lazulyTech/URC_IO-Expander/README.md

# UEC Robotics Competition

## [ゲームルール](GameRule/main.pdf)

日本語がレンダリングされないため，ダウンロードしてご利用ください．
