lazulyTech/URC_IO-Expander/Board/ExternalLib/ADUM140D0BRZ/ADUM140D0BRZ.step

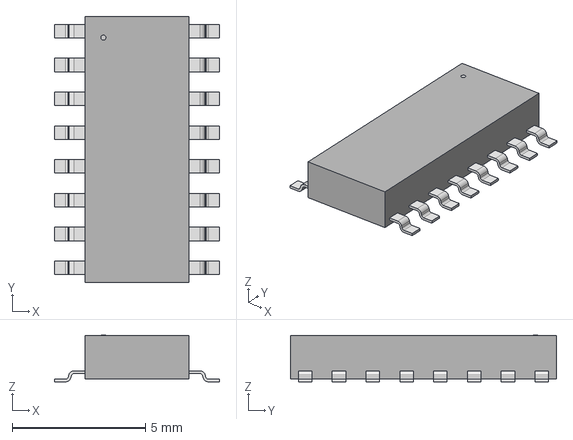
[picture p15: CAD file, 2022-06-05]
Board/ExternalLib/ADUM140D0BRZ/ADUM140D0BRZ.step
6.20 x 10.0 x 1.75 mm
