lazulyTech/URC_IO-Expander/Board/ExternalLib/TB6612FNG/TB6612FNG.step

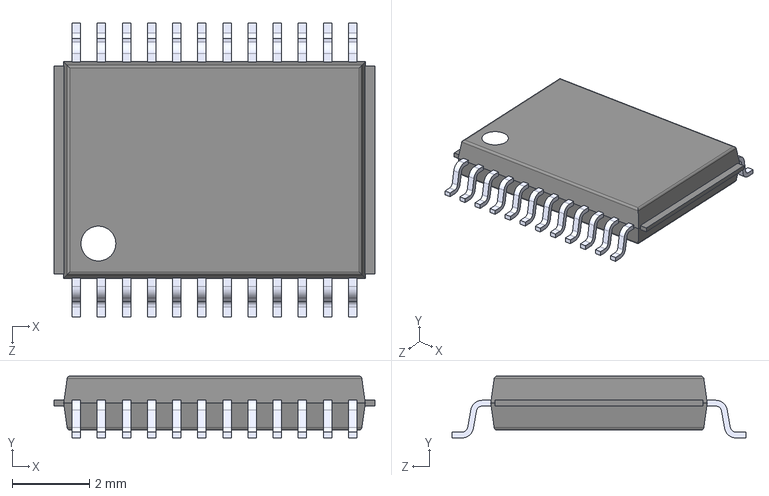
[picture p16: CAD file, 2022-06-05]
Board/ExternalLib/TB6612FNG/TB6612FNG.step
8.30 x 1.60 x 7.60 mm
