lazulyTech/URC_IO-Expander/Board/ExternalLib/TB67H450FNG/TB67H450FNG.step

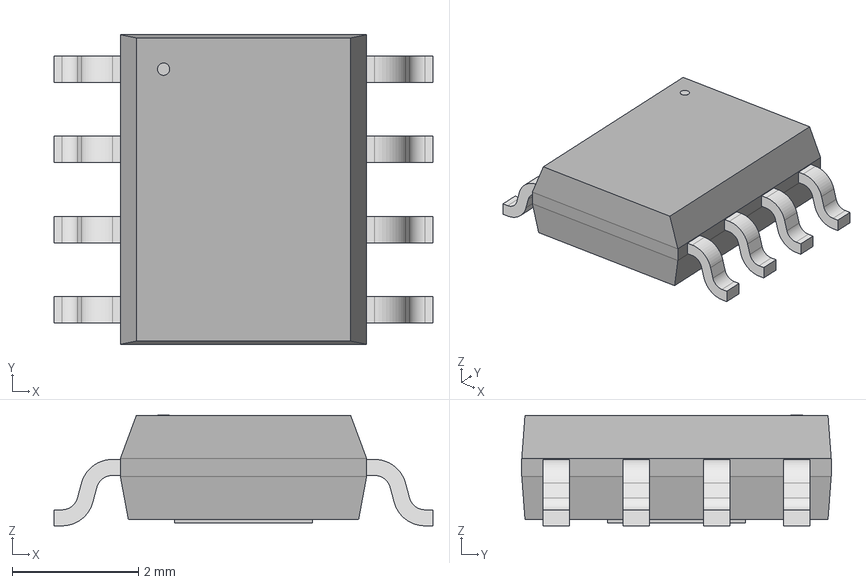
[picture p17: CAD file, 2022-06-05]
Board/ExternalLib/TB67H450FNG/TB67H450FNG.step
6.00 x 4.90 x 1.75 mm
