lazulyTech/URC_IO-Expander/Board/URC_ver2/URC_ver2.kicad_pcb

## KiCad design Board/URC_ver2/URC_ver2.kicad_pcb (2022-07-22)

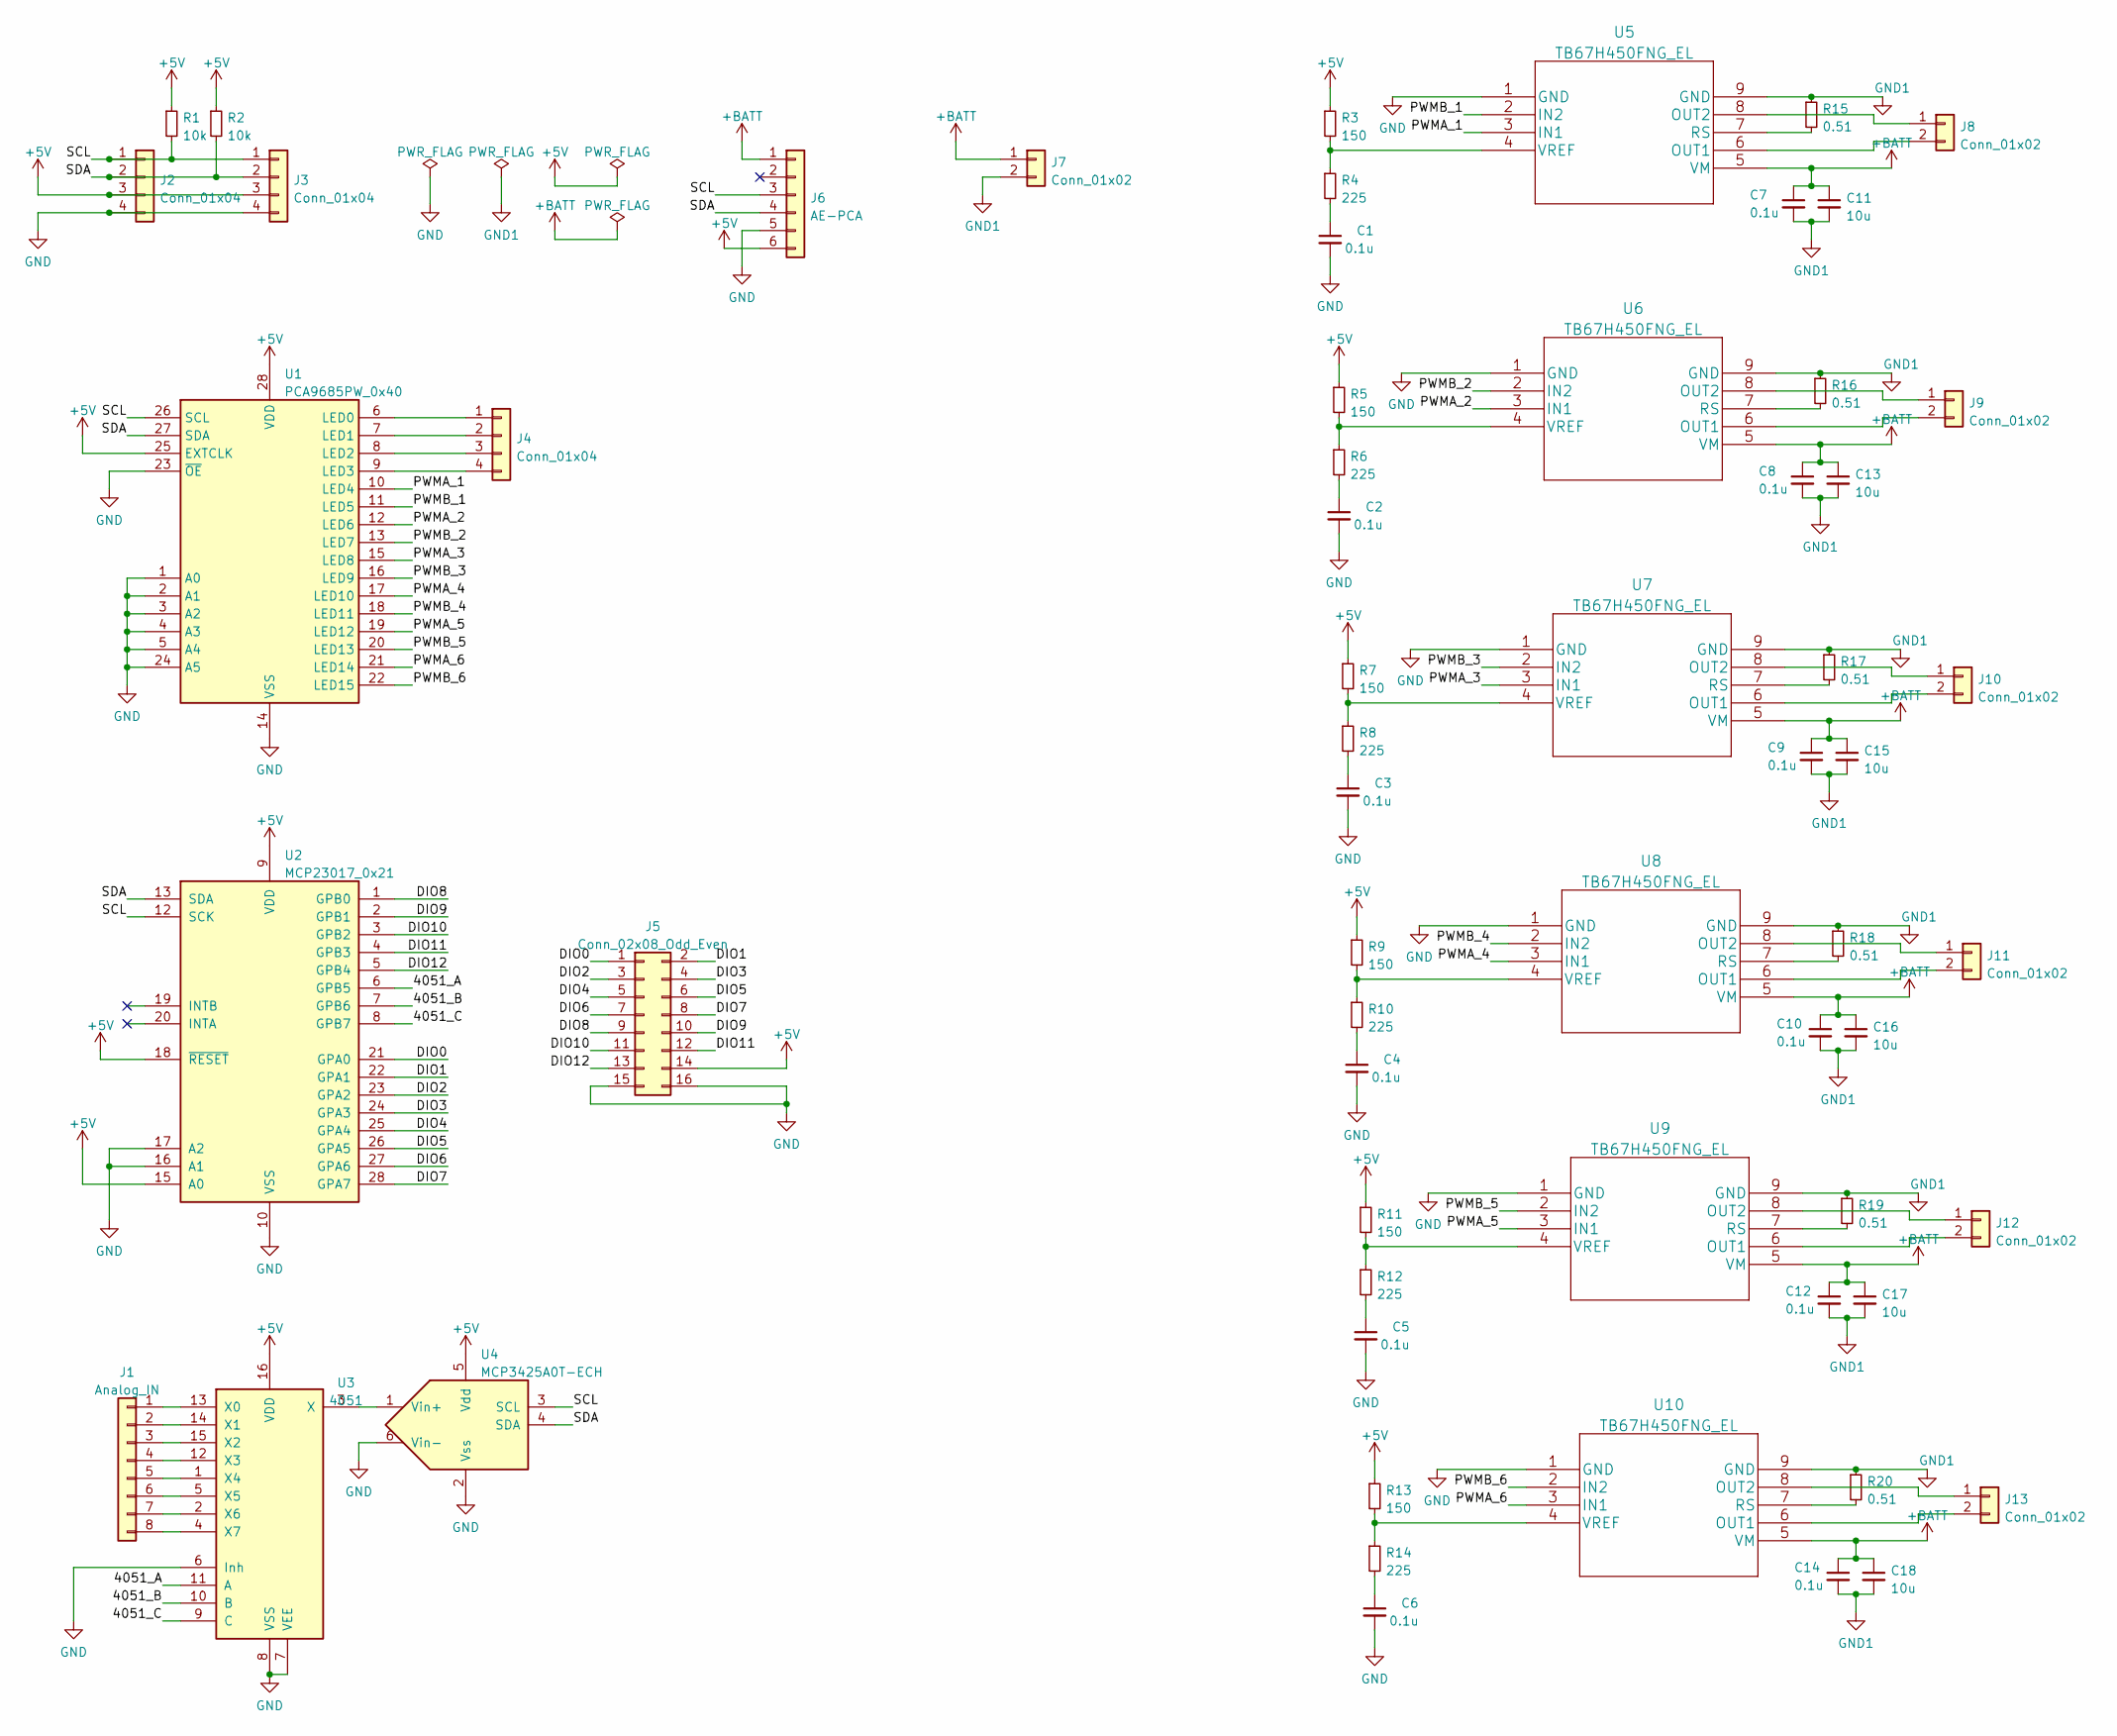
[picture p18: schematic URC_ver2.kicad_sch, BCRC Dev-Board]

Parts:
C1, C2, C3, C4, C5, C6, C7, C8, C9, C10, C12, C14: 0.1u; C_0603_1608Metric_Pad1.08x0.95mm_HandSolder
C11, C13, C15, C16, C17, C18: 10u; C_0603_1608Metric_Pad1.08x0.95mm_HandSolder
J1: Analog_IN; PinSocket_1x08_P2.54mm_Vertical
J2: Conn_01x04; NS-Tech_Grove_1x04_P2mm_Vertical
J3, J4: Conn_01x04; PinSocket_1x04_P2.54mm_Vertical
J5: Conn_02x08_Odd_Even; PinSocket_2x08_P2.54mm_Vertical
J6: AE-PCA; PinSocket_1x06_P2.54mm_Vertical
J7, J8, J9, J10, J11, J12, J13: Conn_01x02; JST_XH_B2B-XH-A_1x02_P2.50mm_Vertical
R1, R2: 10k; R_0603_1608Metric_Pad0.98x0.95mm_HandSolder
R3, R5, R7, R9, R11, R13: 150; R_0603_1608Metric_Pad0.98x0.95mm_HandSolder
R4, R6, R8, R10, R12, R14: 225; R_0603_1608Metric_Pad0.98x0.95mm_HandSolder
R15, R16, R17, R18, R19, R20: 0.51; R_Axial_DIN0204_L3.6mm_D1.6mm_P5.08mm_Horizontal
U1: PCA9685PW_0x40; TSSOP-28_4.4x9.7mm_P0.65mm
U2: MCP23017_0x21; DIP-28_W7.62mm
U3: 4051; DIP-16_W7.62mm_LongPads
U4: MCP3425A0T-ECH; SOT-23-6_Handsoldering
U5, U6, U7, U8, U9, U10: TB67H450FNG_EL; TB67H450FNG

Connections:
+5V: J2.3, J3.3, J5.14, J6.6, R1.1, R2.1, R3.1, R5.1, R7.1, R9.1, R11.1, R13.1, U1.25 (EXTCLK), U1.28 (VDD), U2.9 (VDD), U2.15 (A0), U2.18 (~RESET), U3.16 (VDD), U4.5 (Vdd)
+BATT: C7.1, C8.1, C9.1, C10.1, C11.1, C12.1, C13.1, C14.1, C15.1, C16.1, C17.1, C18.1, J6.1, J7.1, U5.5 (VM), U6.5 (VM), U7.5 (VM), U8.5 (VM), U9.5 (VM), U10.5 (VM)
/4051_A: U2.6 (GPB5), U3.11 (A)
/4051_B: U2.7 (GPB6), U3.10 (B)
/4051_C: U2.8 (GPB7), U3.9 (C)
/DIO0: J5.1, U2.21 (GPA0)
/DIO1: J5.2, U2.22 (GPA1)
/DIO2: J5.3, U2.23 (GPA2)
/DIO3: J5.4, U2.24 (GPA3)
/DIO4: J5.5, U2.25 (GPA4)
/DIO5: J5.6, U2.26 (GPA5)
/DIO6: J5.7, U2.27 (GPA6)
/DIO7: J5.8, U2.28 (GPA7)
/DIO8: J5.9, U2.1 (GPB0)
/DIO9: J5.10, U2.2 (GPB1)
/DIO10: J5.11, U2.3 (GPB2)
/DIO11: J5.12, U2.4 (GPB3)
/DIO12: J5.13, U2.5 (GPB4)
/PWMA_1: U1.10 (LED4), U5.3 (IN1)
/PWMA_2: U1.12 (LED6), U6.3 (IN1)
/PWMA_3: U1.15 (LED8), U7.3 (IN1)
/PWMA_4: U1.17 (LED10), U8.3 (IN1)
/PWMA_5: U1.19 (LED12), U9.3 (IN1)
/PWMA_6: U1.21 (LED14), U10.3 (IN1)
/PWMB_1: U1.11 (LED5), U5.2 (IN2)
/PWMB_2: U1.13 (LED7), U6.2 (IN2)
/PWMB_3: U1.16 (LED9), U7.2 (IN2)
/PWMB_4: U1.18 (LED11), U8.2 (IN2)
/PWMB_5: U1.20 (LED13), U9.2 (IN2)
/PWMB_6: U1.22 (LED15), U10.2 (IN2)
/SCL: J2.1, J3.1, J6.3, R1.2, U1.26 (SCL), U2.12 (SCK), U4.3 (SCL)
/SDA: J2.2, J3.2, J6.4, R2.2, U1.27 (SDA), U2.13 (SDA), U4.4 (SDA)
GND: C1.2, C2.2, C3.2, C4.2, C5.2, C6.2, J2.4, J3.4, J5.15, J5.16, J6.5, U1.1 (A0), U1.2 (A1), U1.3 (A2), U1.4 (A3), U1.5 (A4), U1.14 (VSS), U1.23 (~OE), U1.24 (A5), U2.10 (VSS), U2.16 (A1), U2.17 (A2), U3.6 (Inh), U3.7 (VEE), U3.8 (VSS), U4.2 (Vss), U4.6 (Vin-), U5.1 (GND), U6.1 (GND), U7.1 (GND), U8.1 (GND), U9.1 (GND), U10.1 (GND)
GND1: C7.2, C8.2, C9.2, C10.2, C11.2, C12.2, C13.2, C14.2, C15.2, C16.2, C17.2, C18.2, J7.2, R15.1, R16.1, R17.1, R18.1, R19.1, R20.1, U5.9 (GND), U6.9 (GND), U7.9 (GND), U8.9 (GND), U9.9 (GND), U10.9 (GND)
unnamed: C1.1, R4.2
unnamed: C2.1, R6.2
unnamed: C3.1, R8.2
unnamed: C4.1, R10.2
unnamed: C5.1, R12.2
unnamed: C6.1, R14.2
unnamed: J1.1, U3.13 (X0)
unnamed: J1.2, U3.14 (X1)
unnamed: J1.3, U3.15 (X2)
unnamed: J1.4, U3.12 (X3)
unnamed: J1.5, U3.1 (X4)
unnamed: J1.6, U3.5 (X5)
unnamed: J1.7, U3.2 (X6)
unnamed: J1.8, U3.4 (X7)
unnamed: J8.1, U5.8 (OUT2)
unnamed: J8.2, U5.6 (OUT1)
unnamed: J9.1, U6.8 (OUT2)
unnamed: J9.2, U6.6 (OUT1)
unnamed: J10.1, U7.8 (OUT2)
unnamed: J10.2, U7.6 (OUT1)
unnamed: J11.1, U8.8 (OUT2)
unnamed: J11.2, U8.6 (OUT1)
unnamed: J12.1, U9.8 (OUT2)
unnamed: J12.2, U9.6 (OUT1)
unnamed: J13.1, U10.8 (OUT2)
unnamed: J13.2, U10.6 (OUT1)
unnamed: R3.2, R4.1, U5.4 (VREF)
unnamed: R5.2, R6.1, U6.4 (VREF)
unnamed: R7.2, R8.1, U7.4 (VREF)
unnamed: R9.2, R10.1, U8.4 (VREF)
unnamed: R11.2, R12.1, U9.4 (VREF)
unnamed: R13.2, R14.1, U10.4 (VREF)
unnamed: R15.2, U5.7 (RS)
unnamed: R16.2, U6.7 (RS)
unnamed: R17.2, U7.7 (RS)
unnamed: R18.2, U8.7 (RS)
unnamed: R19.2, U9.7 (RS)
unnamed: R20.2, U10.7 (RS)
unnamed: J4.1, U1.6 (LED0)
unnamed: J4.2, U1.7 (LED1)
unnamed: J4.3, U1.8 (LED2)
unnamed: J4.4, U1.9 (LED3)
unnamed: U3.3 (X), U4.1 (Vin+)

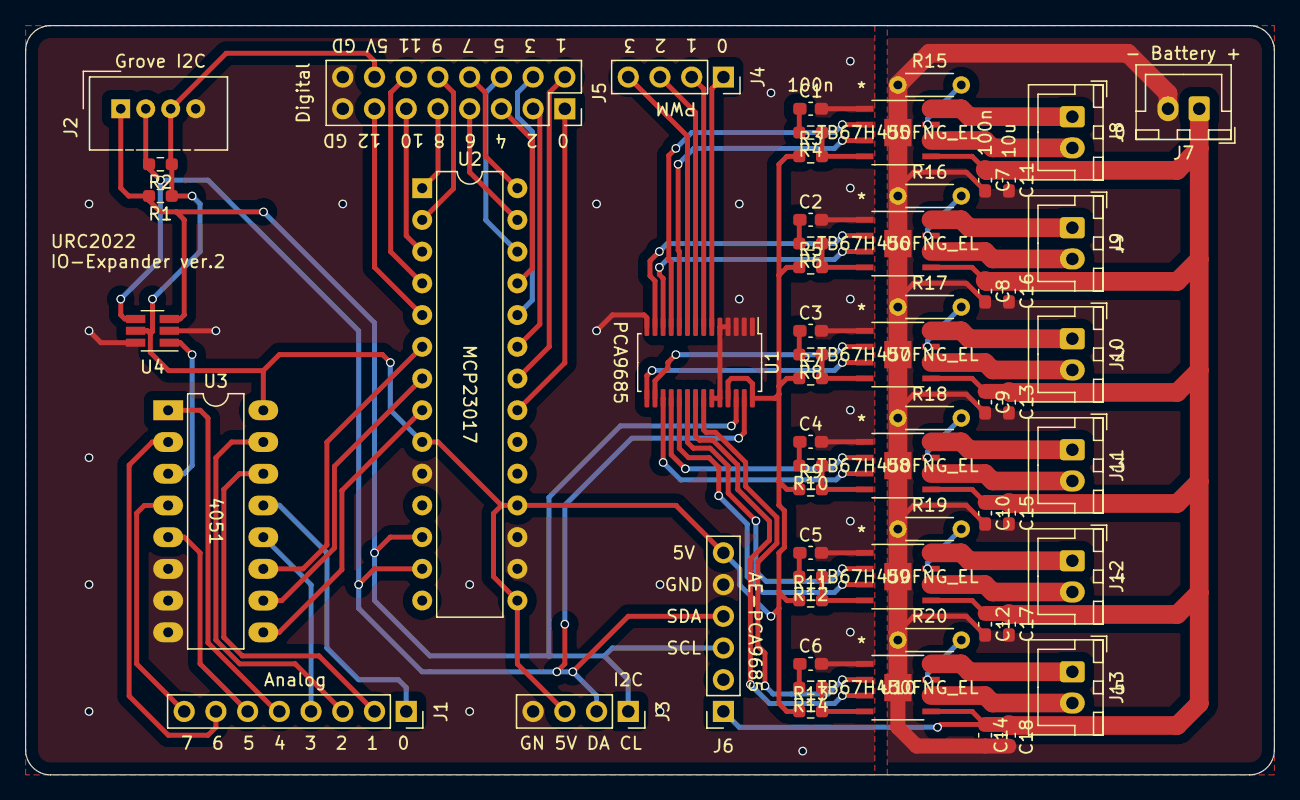
[picture p19: board URC_ver2.kicad_pcb from above]

Board: 2 copper layers, 100.0 x 60.0 mm, 61 parts (0 on the bottom side), 77 nets.
