lazulyTech/URC_IO-Expander/Board/URC_I2C/URC_I2C.kicad_pcb

## KiCad design Board/URC_I2C/URC_I2C.kicad_pcb (2022-06-05)

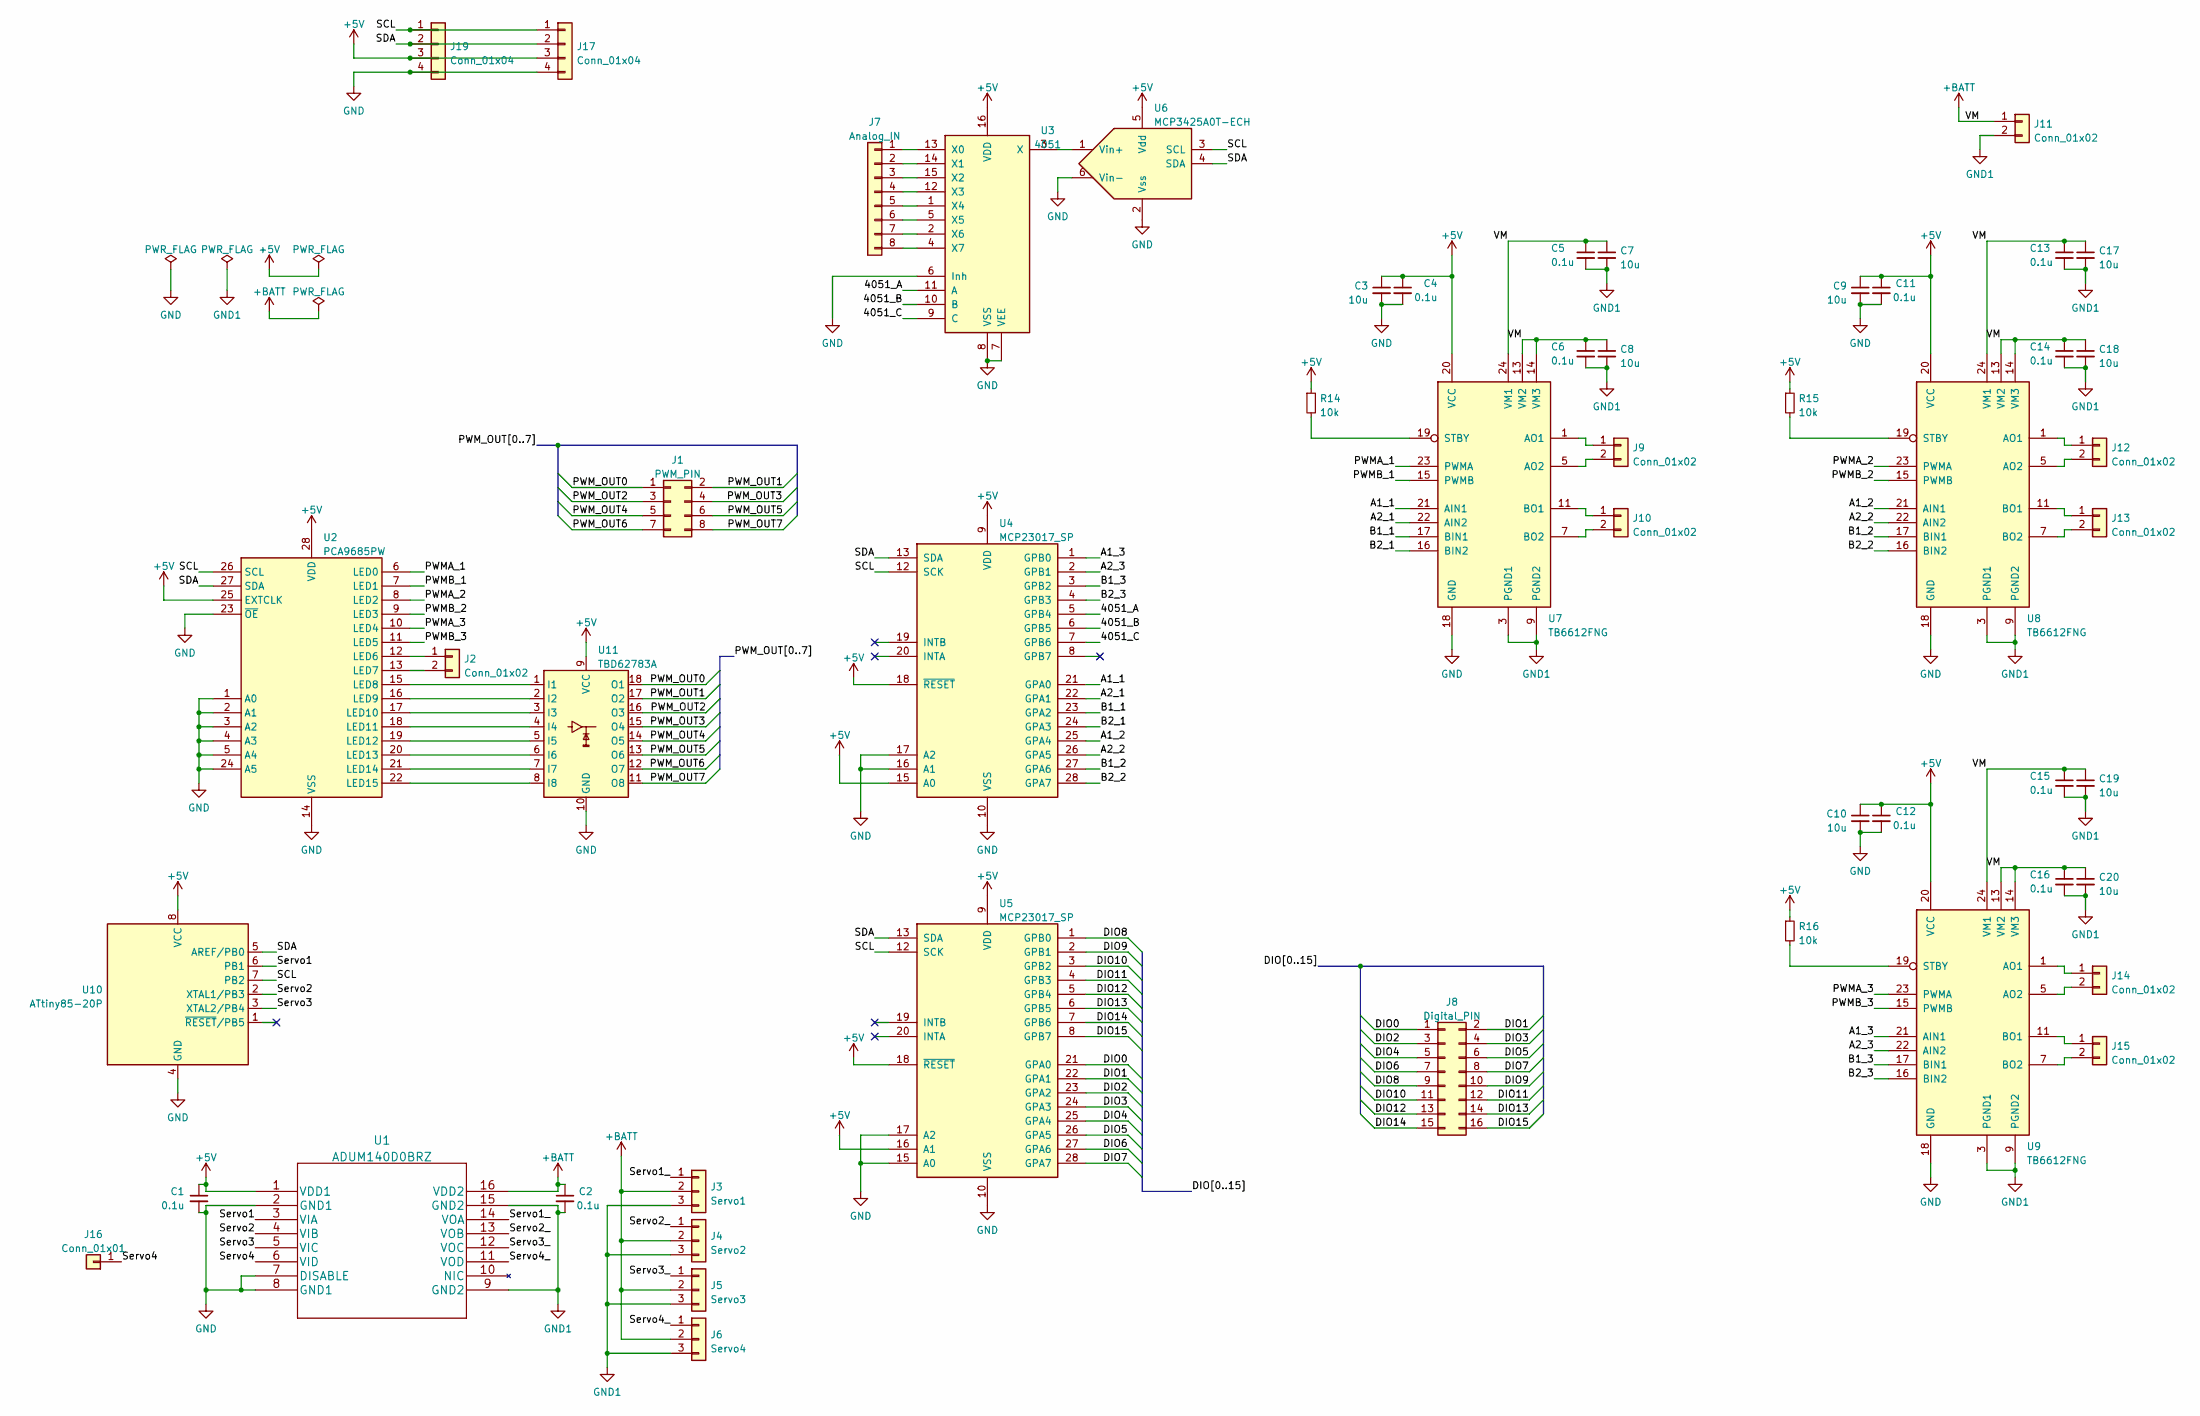
[picture p20: schematic URC_I2C.kicad_sch, BCRC Dev-Board]

Parts:
C1, C2, C4, C5, C6, C11, C12, C13, C14, C15, C16: 0.1u; C_0603_1608Metric_Pad1.08x0.95mm_HandSolder
C3, C7, C8, C9, C10, C17, C18, C19, C20: 10u; C_0603_1608Metric_Pad1.08x0.95mm_HandSolder
J1: PWM_PIN; PinSocket_2x04_P2.54mm_Vertical
J2: Conn_01x02; PinSocket_1x02_P2.54mm_Vertical
J3: Servo1; PinHeader_1x03_P2.54mm_Vertical
J4: Servo2; PinHeader_1x03_P2.54mm_Vertical
J5: Servo3; PinHeader_1x03_P2.54mm_Vertical
J6: Servo4; PinHeader_1x03_P2.54mm_Vertical
J7: Analog_IN; PinSocket_1x08_P2.54mm_Vertical
J8: Digital_PIN; PinSocket_2x08_P2.54mm_Vertical
J9, J10, J11, J12, J13, J14, J15: Conn_01x02; JST_XH_B2B-XH-A_1x02_P2.50mm_Vertical
J16: Conn_01x01; PinSocket_1x01_P2.54mm_Vertical
J17: Conn_01x04; PinSocket_1x04_P2.54mm_Vertical
J19: Conn_01x04; NS-Tech_Grove_1x04_P2mm_Vertical
R14, R15, R16: 10k; R_0805_2012Metric_Pad1.20x1.40mm_HandSolder
U1: ADUM140D0BRZ
U2: PCA9685PW; TSSOP-28_4.4x9.7mm_P0.65mm
U3: 4051; DIP-16_W7.62mm_LongPads
U4, U5: MCP23017_SP; DIP-28_W7.62mm
U6: MCP3425A0T-ECH; SOT-23-6_Handsoldering
U7, U8, U9: TB6612FNG; SSOP-24_5.3x8.2mm_P0.65mm
U10: ATtiny85-20P; DIP-8_W7.62mm
U11: TBD62783A; SOP-18_7x12.5mm_P1.27mm

Connections:
+5V: C1.1, C3.1, C4.1, C9.1, C10.1, C11.1, C12.1, J17.3, J19.3, R14.1, R15.1, R16.1, U1.1 (VDD1), U2.25 (EXTCLK), U2.28 (VDD), U3.16 (VDD), U4.9 (VDD), U4.15 (A0), U4.18 (~RESET), U5.9 (VDD), U5.16 (A1), U5.18 (~RESET), U6.5 (Vdd), U7.20 (VCC), U8.20 (VCC), U9.20 (VCC), U10.8 (VCC), U11.9 (VCC)
+BATT: C2.1, C5.1, C6.1, C7.1, C8.1, C13.1, C14.1, C15.1, C16.1, C17.1, C18.1, C19.1, C20.1, J3.2, J4.2, J5.2, J6.2, J11.1, U1.16 (VDD2), U7.13 (VM2), U7.14 (VM3), U7.24 (VM1), U8.13 (VM2), U8.14 (VM3), U8.24 (VM1), U9.13 (VM2), U9.14 (VM3), U9.24 (VM1)
/4051_A: U3.11 (A), U4.5 (GPB4)
/4051_B: U3.10 (B), U4.6 (GPB5)
/4051_C: U3.9 (C), U4.7 (GPB6)
/A1_1: U4.21 (GPA0), U7.21 (AIN1)
/A1_2: U4.25 (GPA4), U8.21 (AIN1)
/A1_3: U4.1 (GPB0), U9.21 (AIN1)
/A2_1: U4.22 (GPA1), U7.22 (AIN2)
/A2_2: U4.26 (GPA5), U8.22 (AIN2)
/A2_3: U4.2 (GPB1), U9.22 (AIN2)
/B1_1: U4.23 (GPA2), U7.17 (BIN1)
/B1_2: U4.27 (GPA6), U8.17 (BIN1)
/B1_3: U4.3 (GPB2), U9.17 (BIN1)
/B2_1: U4.24 (GPA3), U7.16 (BIN2)
/B2_2: U4.28 (GPA7), U8.16 (BIN2)
/B2_3: U4.4 (GPB3), U9.16 (BIN2)
/DIO0: J8.1, U5.21 (GPA0)
/DIO1: J8.2, U5.22 (GPA1)
/DIO2: J8.3, U5.23 (GPA2)
/DIO3: J8.4, U5.24 (GPA3)
/DIO4: J8.5, U5.25 (GPA4)
/DIO5: J8.6, U5.26 (GPA5)
/DIO6: J8.7, U5.27 (GPA6)
/DIO7: J8.8, U5.28 (GPA7)
/DIO8: J8.9, U5.1 (GPB0)
/DIO9: J8.10, U5.2 (GPB1)
/DIO10: J8.11, U5.3 (GPB2)
/DIO11: J8.12, U5.4 (GPB3)
/DIO12: J8.13, U5.5 (GPB4)
/DIO13: J8.14, U5.6 (GPB5)
/DIO14: J8.15, U5.7 (GPB6)
/DIO15: J8.16, U5.8 (GPB7)
/PWMA_1: U2.6 (LED0), U7.23 (PWMA)
/PWMA_2: U2.8 (LED2), U8.23 (PWMA)
/PWMA_3: U2.10 (LED4), U9.23 (PWMA)
/PWMB_1: U2.7 (LED1), U7.15 (PWMB)
/PWMB_2: U2.9 (LED3), U8.15 (PWMB)
/PWMB_3: U2.11 (LED5), U9.15 (PWMB)
/PWM_OUT0: J1.1, U11.18 (O1)
/PWM_OUT1: J1.2, U11.17 (O2)
/PWM_OUT2: J1.3, U11.16 (O3)
/PWM_OUT3: J1.4, U11.15 (O4)
/PWM_OUT4: J1.5, U11.14 (O5)
/PWM_OUT5: J1.6, U11.13 (O6)
/PWM_OUT6: J1.7, U11.12 (O7)
/PWM_OUT7: J1.8, U11.11 (O8)
/SCL: J17.1, J19.1, U2.26 (SCL), U4.12 (SCK), U5.12 (SCK), U6.3 (SCL), U10.7 (PB2)
/SDA: J17.2, J19.2, U2.27 (SDA), U4.13 (SDA), U5.13 (SDA), U6.4 (SDA), U10.5 (AREF/PB0)
/Servo1: U1.3 (VIA), U10.6 (PB1)
/Servo1_: J3.1, U1.14 (VOA)
/Servo2: U1.4 (VIB), U10.2 (XTAL1/PB3)
/Servo2_: J4.1, U1.13 (VOB)
/Servo3: U1.5 (VIC), U10.3 (XTAL2/PB4)
/Servo3_: J5.1, U1.12 (VOC)
/Servo4: J16.1, U1.6 (VID)
/Servo4_: J6.1, U1.11 (VOD)
GND: C1.2, C3.2, C4.2, C9.2, C10.2, C11.2, C12.2, J17.4, J19.4, U1.2 (GND1), U1.7 (DISABLE), U1.8 (GND1), U2.1 (A0), U2.2 (A1), U2.3 (A2), U2.4 (A3), U2.5 (A4), U2.14 (VSS), U2.23 (~OE), U2.24 (A5), U3.6 (Inh), U3.7 (VEE), U3.8 (VSS), U4.10 (VSS), U4.16 (A1), U4.17 (A2), U5.10 (VSS), U5.15 (A0), U5.17 (A2), U6.2 (Vss), U6.6 (Vin-), U7.18 (GND), U8.18 (GND), U9.18 (GND), U10.4 (GND), U11.10 (GND)
GND1: C2.2, C5.2, C6.2, C7.2, C8.2, C13.2, C14.2, C15.2, C16.2, C17.2, C18.2, C19.2, C20.2, J3.3, J4.3, J5.3, J6.3, J11.2, U1.9 (GND2), U1.15 (GND2), U7.3 (PGND1), U7.4 (PGND1), U7.9 (PGND2), U7.10 (PGND2), U8.3 (PGND1), U8.4 (PGND1), U8.9 (PGND2), U8.10 (PGND2), U9.3 (PGND1), U9.4 (PGND1), U9.9 (PGND2), U9.10 (PGND2)
unnamed: J2.1, U2.12 (LED6)
unnamed: J2.2, U2.13 (LED7)
unnamed: J7.1, U3.13 (X0)
unnamed: J7.2, U3.14 (X1)
unnamed: J7.3, U3.15 (X2)
unnamed: J7.4, U3.12 (X3)
unnamed: J7.5, U3.1 (X4)
unnamed: J7.6, U3.5 (X5)
unnamed: J7.7, U3.2 (X6)
unnamed: J7.8, U3.4 (X7)
unnamed: J9.1, U7.1 (AO1), U7.2 (AO1)
unnamed: J9.2, U7.5 (AO2), U7.6 (AO2)
unnamed: J10.1, U7.11 (BO1), U7.12 (BO1)
unnamed: J10.2, U7.7 (BO2), U7.8 (BO2)
unnamed: J12.1, U8.1 (AO1), U8.2 (AO1)
unnamed: J12.2, U8.5 (AO2), U8.6 (AO2)
unnamed: J13.1, U8.11 (BO1), U8.12 (BO1)
unnamed: J13.2, U8.7 (BO2), U8.8 (BO2)
unnamed: J14.1, U9.1 (AO1), U9.2 (AO1)
unnamed: J14.2, U9.5 (AO2), U9.6 (AO2)
unnamed: J15.1, U9.11 (BO1), U9.12 (BO1)
unnamed: J15.2, U9.7 (BO2), U9.8 (BO2)
unnamed: R14.2, U7.19 (STBY)
unnamed: R15.2, U8.19 (STBY)
unnamed: R16.2, U9.19 (STBY)
unnamed: U3.3 (X), U6.1 (Vin+)
unnamed: U2.15 (LED8), U11.1 (I1)
unnamed: U2.16 (LED9), U11.2 (I2)
unnamed: U2.17 (LED10), U11.3 (I3)
unnamed: U2.18 (LED11), U11.4 (I4)
unnamed: U2.19 (LED12), U11.5 (I5)
unnamed: U2.20 (LED13), U11.6 (I6)
unnamed: U2.21 (LED14), U11.7 (I7)
unnamed: U2.22 (LED15), U11.8 (I8)

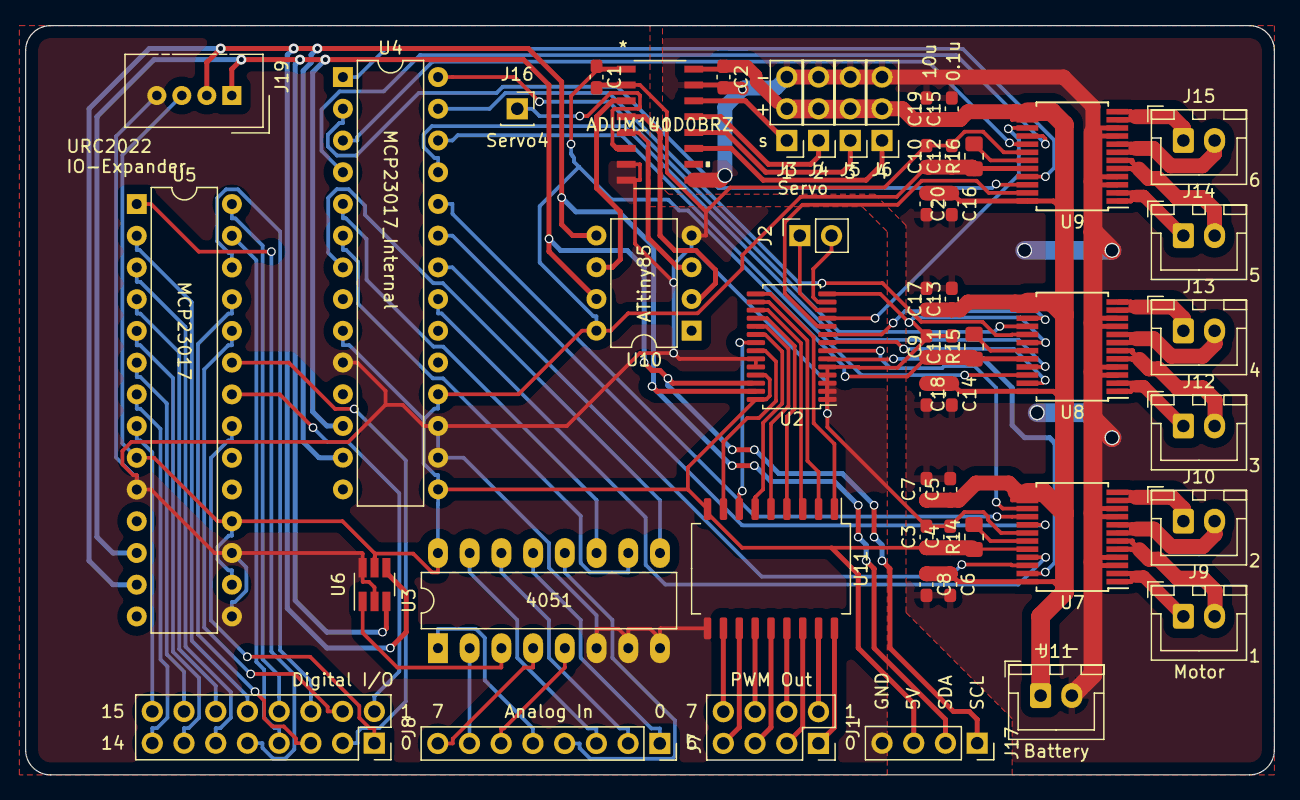
[picture p21: board URC_I2C.kicad_pcb from above]

Board: 2 copper layers, 100.0 x 60.0 mm, 52 parts (0 on the bottom side), 93 nets.
