lazulyTech/URC_IO-Expander/(commit log)

2022-06-05 拡張基板を作成
    [ADUM140D0BRZ.step, TB6612FNG.step, TB67H450FNG.step, URC_I2C.kicad_pcb, URC_I2C.kicad_sch]
2022-06-17 ゲームルールをアップロード
2022-06-17 ゲームルールを更新
2022-06-27 Firmwareのgitignoreを追加
2022-06-27 RobotSystemを移動
2022-06-29 M5StickC Firmwareの更新
2022-06-29 imgを追加
2022-06-29 README.mdを更新
2022-07-22 ファームウェアアップデート
2022-07-22 基板アップデート
    [URC_ver2.kicad_pcb, URC_ver2.kicad_sch]
